vasyna/esphome-blind/blind/box/IMG_1.jpg

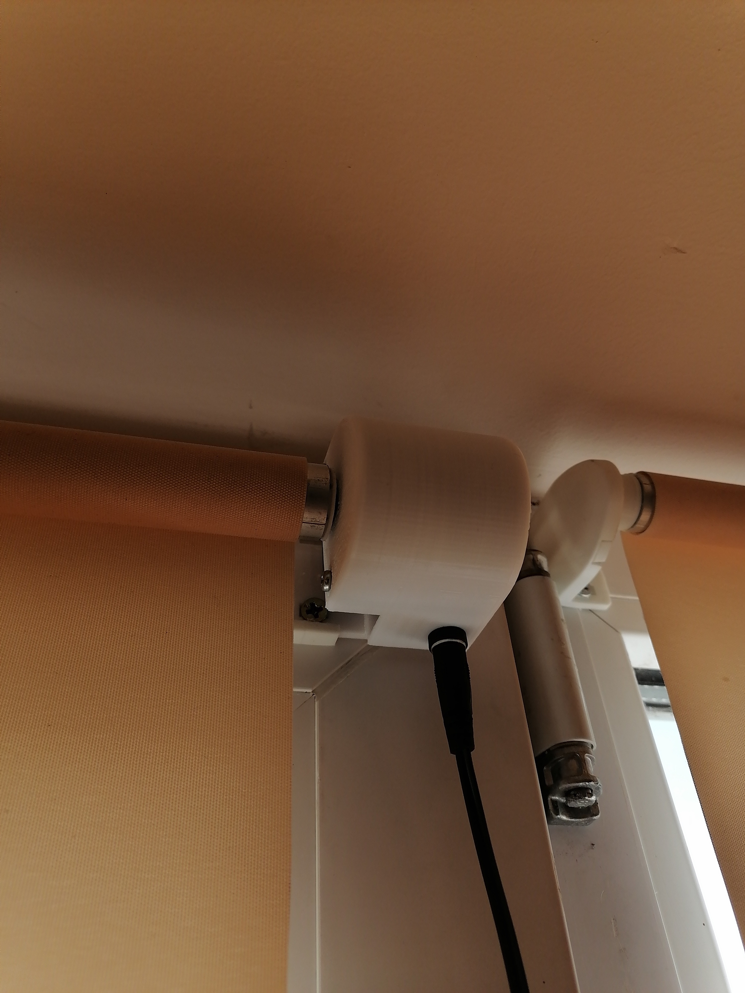
blind/box/IMG_1.jpg
