vasyna/esphome-blind/blind/box/part2.stp

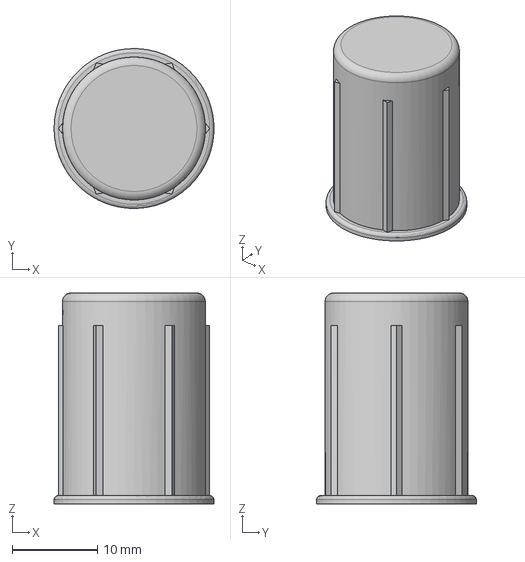
[picture p2: CAD file, 2023-05-25]
blind/box/part2.stp
18.8 x 18.8 x 24.8 mm
