vasyna/esphome-blind/blind/box/part3.stp

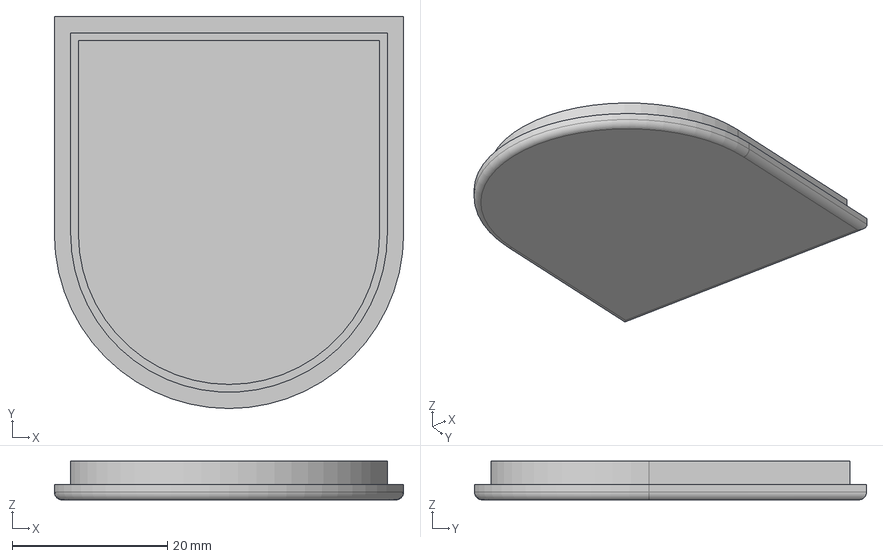
[picture p3: CAD file, 2023-05-25]
blind/box/part3.stp
45.0 x 50.5 x 5.00 mm
