vasyna/esphome-blind/blind/box/part1.stp

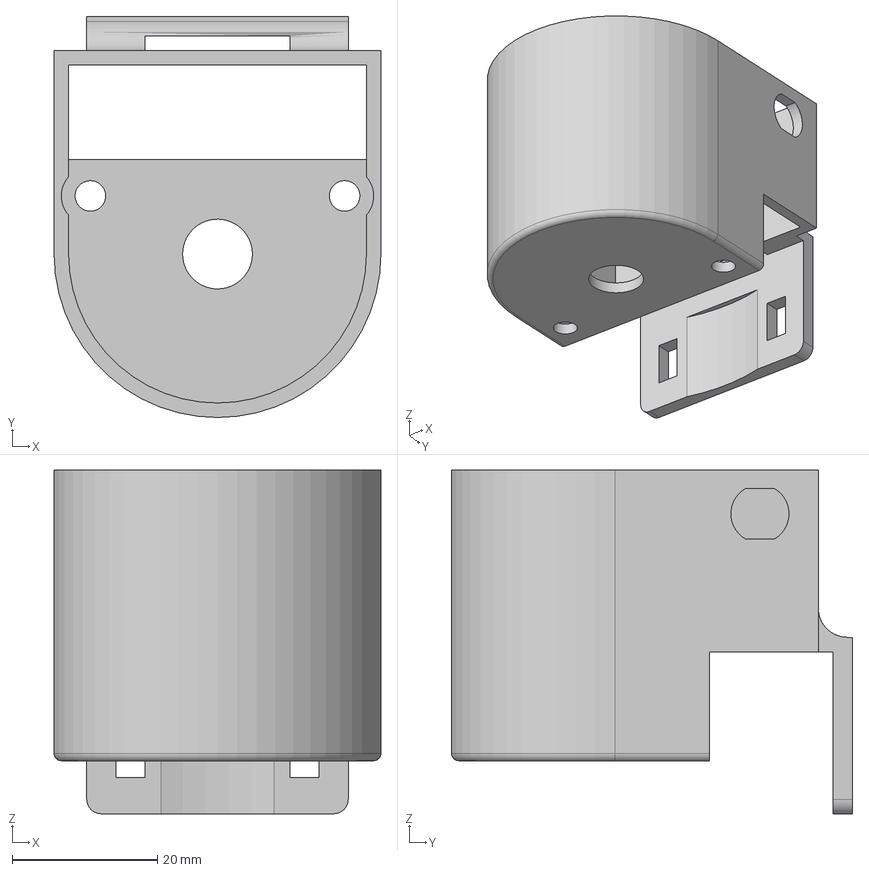
[picture p4: CAD file, 2023-05-25]
blind/box/part1.stp
45.0 x 55.2 x 47.3 mm
