vasyna/esphome-blind/(list of files, cad)

Other CAD files:
blind/box/part1.stl
blind/box/part2.stl
blind/box/part3.stl
